joedvorak/PiDAR/(list of files, cad)

Other CAD files:
LiDAR Mount/AS 1237 - 1.ipt
LiDAR Mount/AS 1427 - M2.5 x 16(5) II.ipt
LiDAR Mount/Bottom Clamp.ipt
LiDAR Mount/LiDAR_mount_Mounting Plate.ipt
LiDAR Mount/LiDAR_mount_RPi Box Top.ipt
LiDAR Mount/LiDAR_mount_RPiBoxBottom_Update.ipt
LiDAR Mount/LiDAR_mount_Top Clamp.ipt
LiDAR Mount/LiDAR_mount_spacer_Rev.1.ipt
LiDAR Mount/LiDAR_mount_sweepclamp_Rev.1.ipt
LiDAR Mount/LiDAR_mount_sweepclamp_Rev.2.ipt
LiDAR Mount/SweepV0.991_BASE_Rev.1.ipt
LiDAR Mount/SweepV0.991_HEAD_Rev.1.ipt
LiDAR Mount/SweepV0.991_Unit Assy_Rev.1.ipt.iam
