joedvorak/PiDAR/(commit log)

2018-07-17 Added Arduino files
2018-07-17 Update Readme and arrange files
    [AS 1237 - 1.ipt, AS 1427 - M2.5 x 16(5) II.ipt, Bottom Clamp.ipt, LiDAR_mount_Mounting Plate.ipt, LiDAR_mount_RPi Box Top.ipt, LiDAR_mount_RPiBoxBottom_Update.ipt, LiDAR_mount_Top Clamp.ipt, LiDAR_mount_spacer_Rev.1.ipt]
